Georgia-Tech-GNC/telemetry-board-pcb/README.md

# KiCad Project Template
Copy this template to quickly start a new KiCad project.

## Setup Steps
1. Copy template
2. SOME STUFF
3. Add libraries to project library table
