Georgia-Tech-GNC/telemetry-board-pcb/telemetry.step

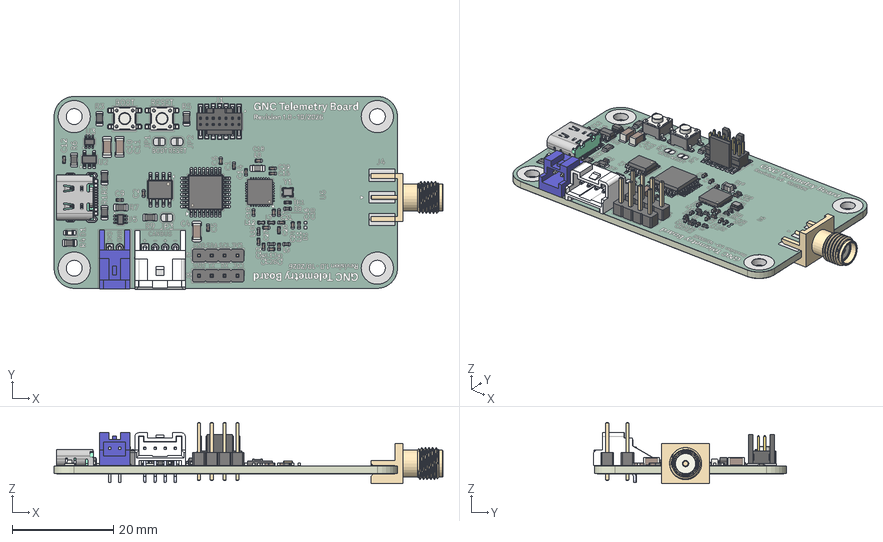
[picture p1: CAD file, 2026-11-03]
telemetry.step
77.0 x 38.3 x 12.1 mm
L_0402_1005Metric x 6
L_0805_2012Metric
QFN-32-1EP_5x5mm_P0.5mm_EP3.7x3.7mm
C_0402_1005Metric x 21
PinHeader_1x04_P254mm_Vertical x 2
SOT-363_SC-70-6 x 2
LQFP-32_7x7mm_P0.8mm
R_0402_1005Metric x 2
C_1206_3216Metric x 3
Crystal_SMD_2016-4Pin_2.0x1.6mm
R_0805_2012Metric x 8
S02B-PASK-2
SOIC-8_3.9x4.9mm_P1.27mm
_X2_4E006B21_X0_MOLDING_-261340
SW_SPST_PTS647Sx38 x 2
SMA_Molex_73251-1153_EdgeMount_Horizontal
LED_0603_1608Metric
FTSH-107-01-L-DV-K-A_body
FTSH-107-01-L-DV-K-A_pins1
FTSH-107-01-L-DV-K-A_pins2
SOT-23-5
telemetry-unsaved-export-rzqZC5_copper
telemetry-unsaved-export-rzqZC5_pad
telemetry-unsaved-export-rzqZC5_silkscreen x 2
telemetry-unsaved-export-rzqZC5_soldermask x 2
telemetry-unsaved-export-rzqZC5_PCB
