Georgia-Tech-GNC/telemetry-board-pcb/telemetry.kicad_pcb

## KiCad design telemetry.kicad_pcb (2026-11-03)

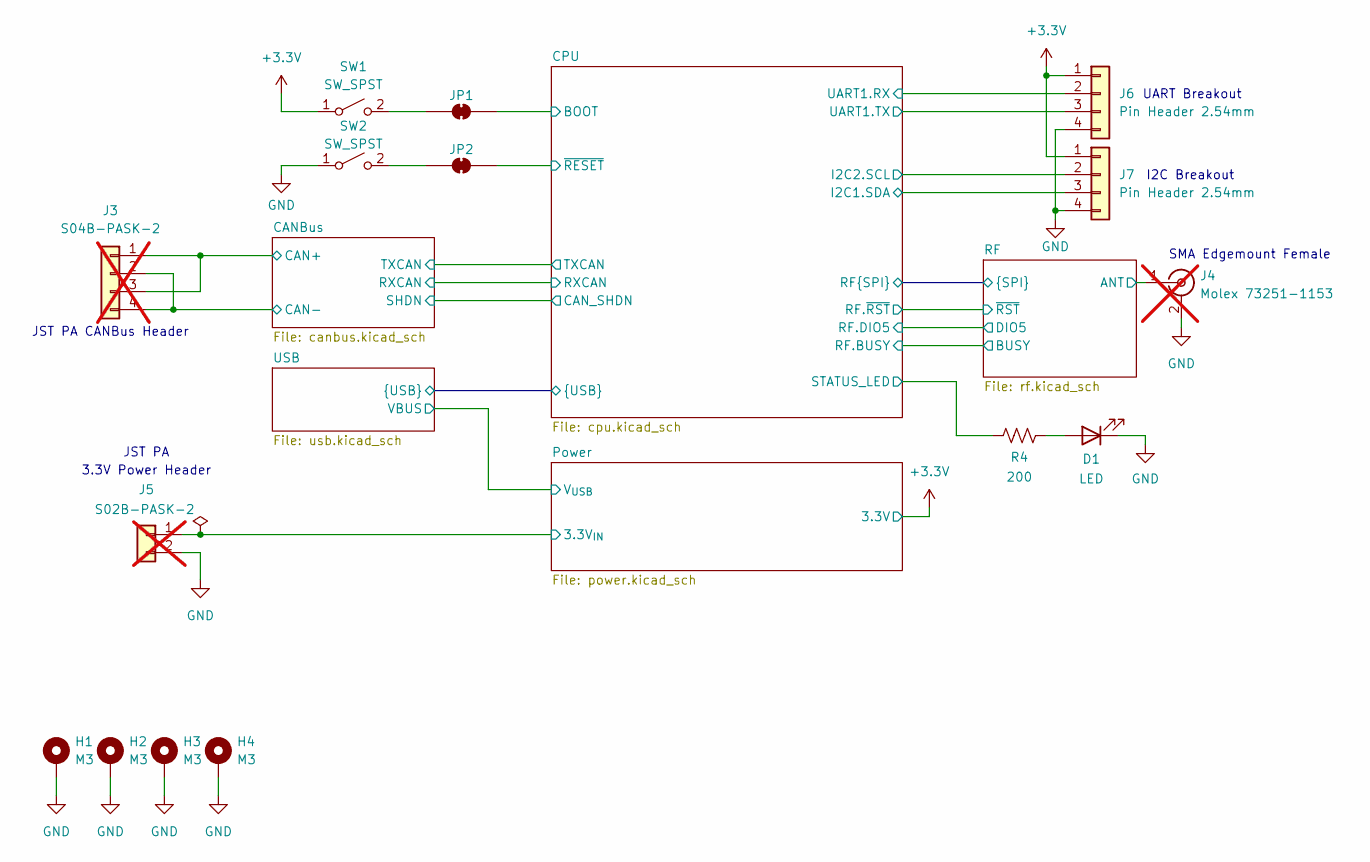
[picture p2: schematic telemetry.kicad_sch, Telemetry Board]

Parts:
D1: LED; LED_0603_1608Metric; MPN KT-0603R; LCSC C2286
H1, H2, H3, H4: M3; MountingHole_3.2mm_M3_Pad
J3: S04B-PASK-2; JST_S04B-PASK-2_LF__SN_; MPN S04B-PASK-2; Digikey 455-S04B-PASK-2-ND; not fitted
J4: Molex 73251-1153; SMA_Molex_73251-1153_EdgeMount_Horizontal; MPN 732511150; LCSC C841205; not fitted
J5: S02B-PASK-2; JST_S02B-PASK-2; MPN S02B-PASK-2; Digikey 455-S02B-PASK-2-ND; not fitted
J6, J7: Pin Header 2.54mm; PinHeader_1x04_P2.54mm_Vertical
JP1, JP2: SolderJumper_2_Bridged; SolderJumper-2_P1.3mm_Bridged_RoundedPad1.0x1.5mm
R4: 200; R_0805_2012Metric; MPN 0805W8F2000T5E; LCSC C17540
SW1, SW2: SW_SPST; SW_SPST_PTS647_Sx38; MPN PTS 647 SN38 SMTR2 LFS; LCSC C2799279

Connections:
+3.3V: J6.1, J7.1, SW1.1 (A); also elsewhere on the board
/CANBus/CAN+: J3.1, J3.3; also elsewhere on the board
/CANBus/CAN-: J3.2, J3.4; also elsewhere on the board
/CPU/BOOT: JP1.2 (B); also elsewhere on the board
/CPU/I2C1.SDA: J7.3; also elsewhere on the board
/CPU/I2C2.SCL: J7.2; also elsewhere on the board
/CPU/STATUS_LED: R4.1; also elsewhere on the board
/CPU/UART1.RX: J6.2; also elsewhere on the board
/CPU/UART1.TX: J6.3; also elsewhere on the board
/CPU/~RESET: JP2.2 (B); also elsewhere on the board
/Power/3.3V_{IN}: J5.1; also elsewhere on the board
/RF/ANT: J4.1 (In); also elsewhere on the board
GND: D1.1 (K), H1.1 (1_1), H2.1 (1_1), H3.1 (1_1), H4.1 (1_1), J4.2 (Ext), J5.2, J6.4, J7.4, SW2.1 (A); also elsewhere on the board
unnamed: D1.2 (A), R4.2
unnamed: JP1.1 (A), SW1.2 (B)
unnamed: JP2.1 (A), SW2.2 (B)

Notes on the sheet:
I2C Breakout
JST PA CANBus Header
3.3V Power Header
UART Breakout
SMA Edgemount Female
JST PA

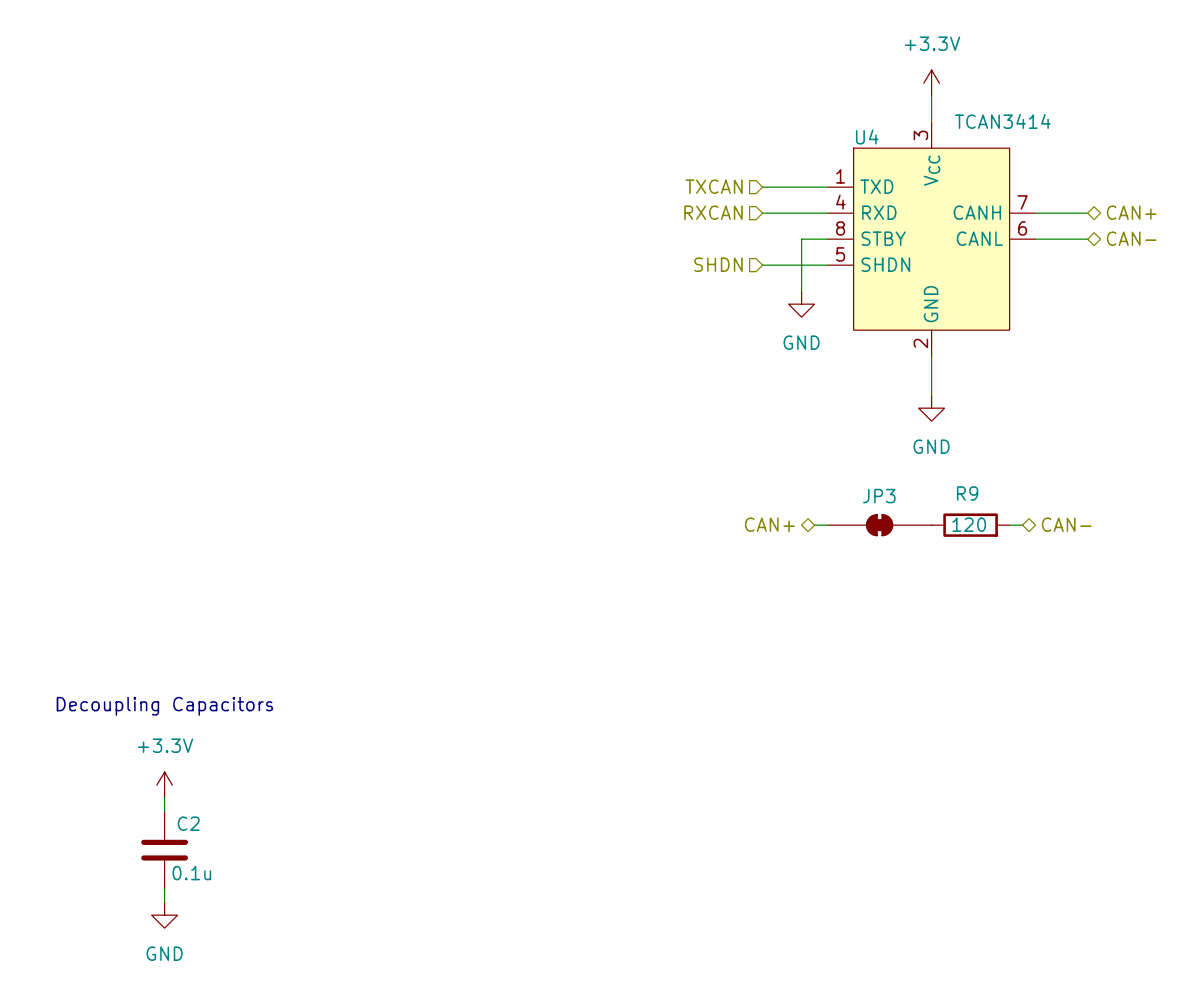
[picture p3: schematic canbus.kicad_sch]

Parts:
C2: 0.1u; C_0402_1005Metric; MPN CL05B104KO5NNNC; Digikey 1276-1003-1-ND
JP3: SolderJumper_2_Bridged; SolderJumper-2_P1.3mm_Bridged_RoundedPad1.0x1.5mm
R9: 120; R_0805_2012Metric; MPN 0805W8F1200T5E; LCSC C17437
U4: TCAN3414; SOIC-8_3.9x4.9mm_P1.27mm; MPN TCAN3413DR; LCSC C22433320

Connections:
+3.3V: C2.1, U4.3 (V_{CC}); also elsewhere on the board
/CANBus/CAN+: JP3.1 (A), U4.7 (CANH); also elsewhere on the board
/CANBus/CAN-: R9.2, U4.6 (CANL); also elsewhere on the board
/CANBus/RXCAN: U4.4 (RXD); also elsewhere on the board
/CANBus/SHDN: U4.5 (SHDN); also elsewhere on the board
/CANBus/TXCAN: U4.1 (TXD); also elsewhere on the board
GND: C2.2, U4.2 (GND), U4.8 (STBY); also elsewhere on the board
unnamed: JP3.2 (B), R9.1

Notes on the sheet:
Decoupling Capacitors

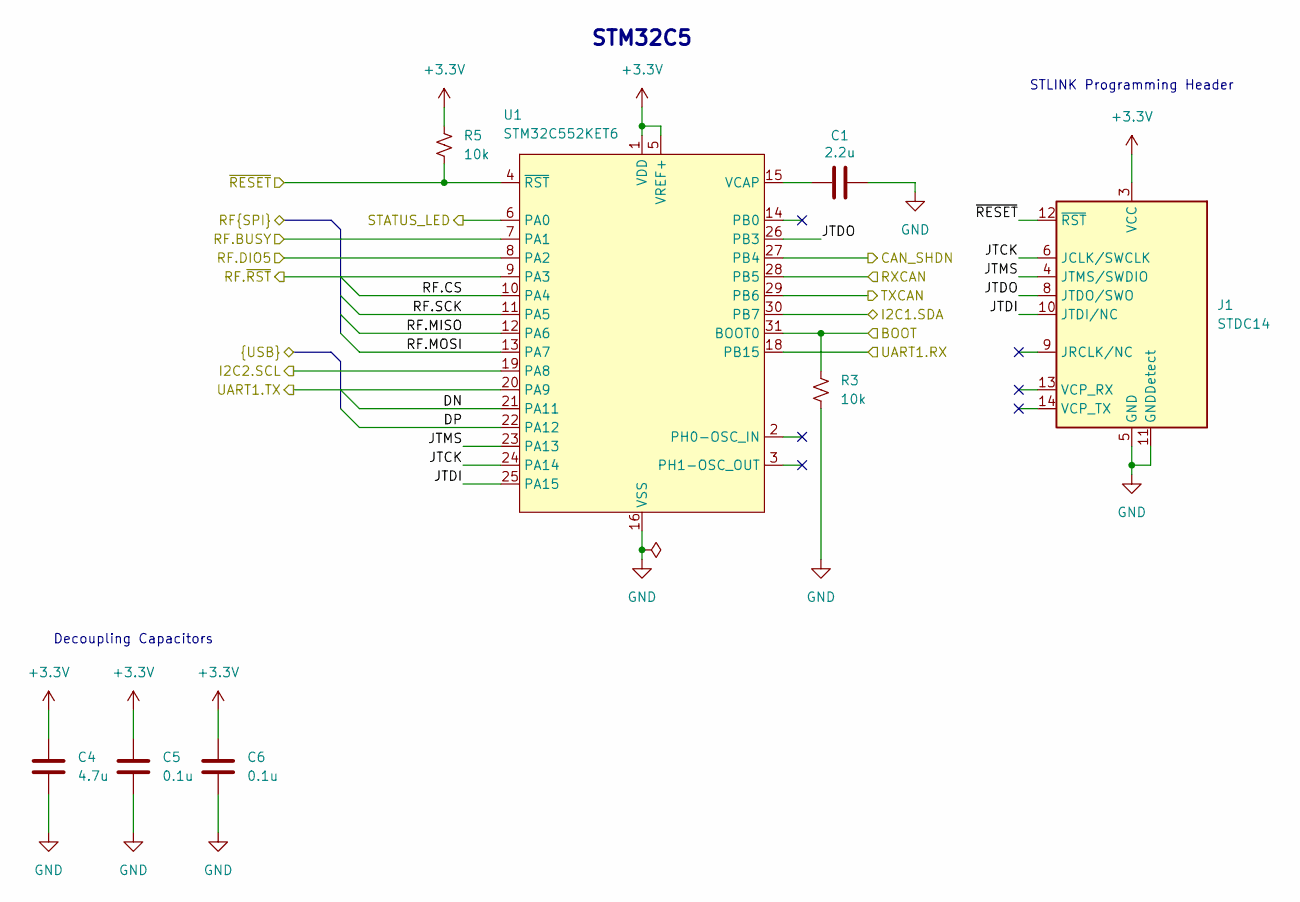
[picture p4: schematic cpu.kicad_sch, STM32C5]

Parts:
C1: 2.2u; C_0402_1005Metric; MPN CL05A225MQ5NSNC; LCSC C12530
C4: 4.7u; C_1206_3216Metric; MPN CL31B475KBHNNNE; LCSC C51205
C5, C6: 0.1u; C_0402_1005Metric; MPN CL05B104KO5NNNC; Digikey 1276-1003-1-ND
J1: STDC14; SAMTEC_FTSH-107-01-L-DV-K-A; MPN FTSH-107-01-L-DV-K-A; LCSC C5563894
R3, R5: 10k; R_0805_2012Metric; MPN 0805W8F1002T5E; LCSC C17414
U1: STM32C552KET6; LQFP-32_7x7mm_P0.8mm; MPN STM32C552KET6; Digikey 497-STM32C552KET6-ND

Connections:
+3.3V: C4.1, C5.1, C6.1, J1.3 (VCC), R5.1, U1.1 (VDD), U1.5 (VREF+), U1.17 (VDD); also elsewhere on the board
/CANBus/RXCAN: U1.28 (PB5); also elsewhere on the board
/CANBus/SHDN: U1.27 (PB4); also elsewhere on the board
/CANBus/TXCAN: U1.29 (PB6); also elsewhere on the board
/CPU/BOOT: R3.1, U1.31 (BOOT0); also elsewhere on the board
/CPU/DN: U1.21 (PA11); also elsewhere on the board
/CPU/DP: U1.22 (PA12); also elsewhere on the board
/CPU/I2C1.SDA: U1.30 (PB7); also elsewhere on the board
/CPU/I2C2.SCL: U1.19 (PA8); also elsewhere on the board
/CPU/JTCK: J1.6 (JCLK/SWCLK), U1.24 (PA14)
/CPU/JTDI: J1.10 (JTDI/NC), U1.25 (PA15)
/CPU/JTDO: J1.8 (JTDO/SWO), U1.26 (PB3)
/CPU/JTMS: J1.4 (JTMS/SWDIO), U1.23 (PA13)
/CPU/RF.BUSY: U1.7 (PA1); also elsewhere on the board
/CPU/RF.CS: U1.10 (PA4); also elsewhere on the board
/CPU/RF.DIO5: U1.8 (PA2); also elsewhere on the board
/CPU/RF.MISO: U1.12 (PA6); also elsewhere on the board
/CPU/RF.MOSI: U1.13 (PA7); also elsewhere on the board
/CPU/RF.SCK: U1.11 (PA5); also elsewhere on the board
/CPU/RF.~RST: U1.9 (PA3); also elsewhere on the board
/CPU/STATUS_LED: U1.6 (PA0); also elsewhere on the board
/CPU/UART1.RX: U1.18 (PB15); also elsewhere on the board
/CPU/UART1.TX: U1.20 (PA9); also elsewhere on the board
/CPU/~RESET: J1.12 (~RST), R5.2, U1.4 (~RST); also elsewhere on the board
GND: C1.2, C4.2, C5.2, C6.2, J1.5 (GND), J1.7 (GND), J1.11 (GNDDetect), R3.2, U1.16 (VSS), U1.32 (VSS); also elsewhere on the board
unnamed: C1.1, U1.15 (VCAP)

Notes on the sheet:
STLINK Programming Header
Decoupling Capacitors
STM32C5

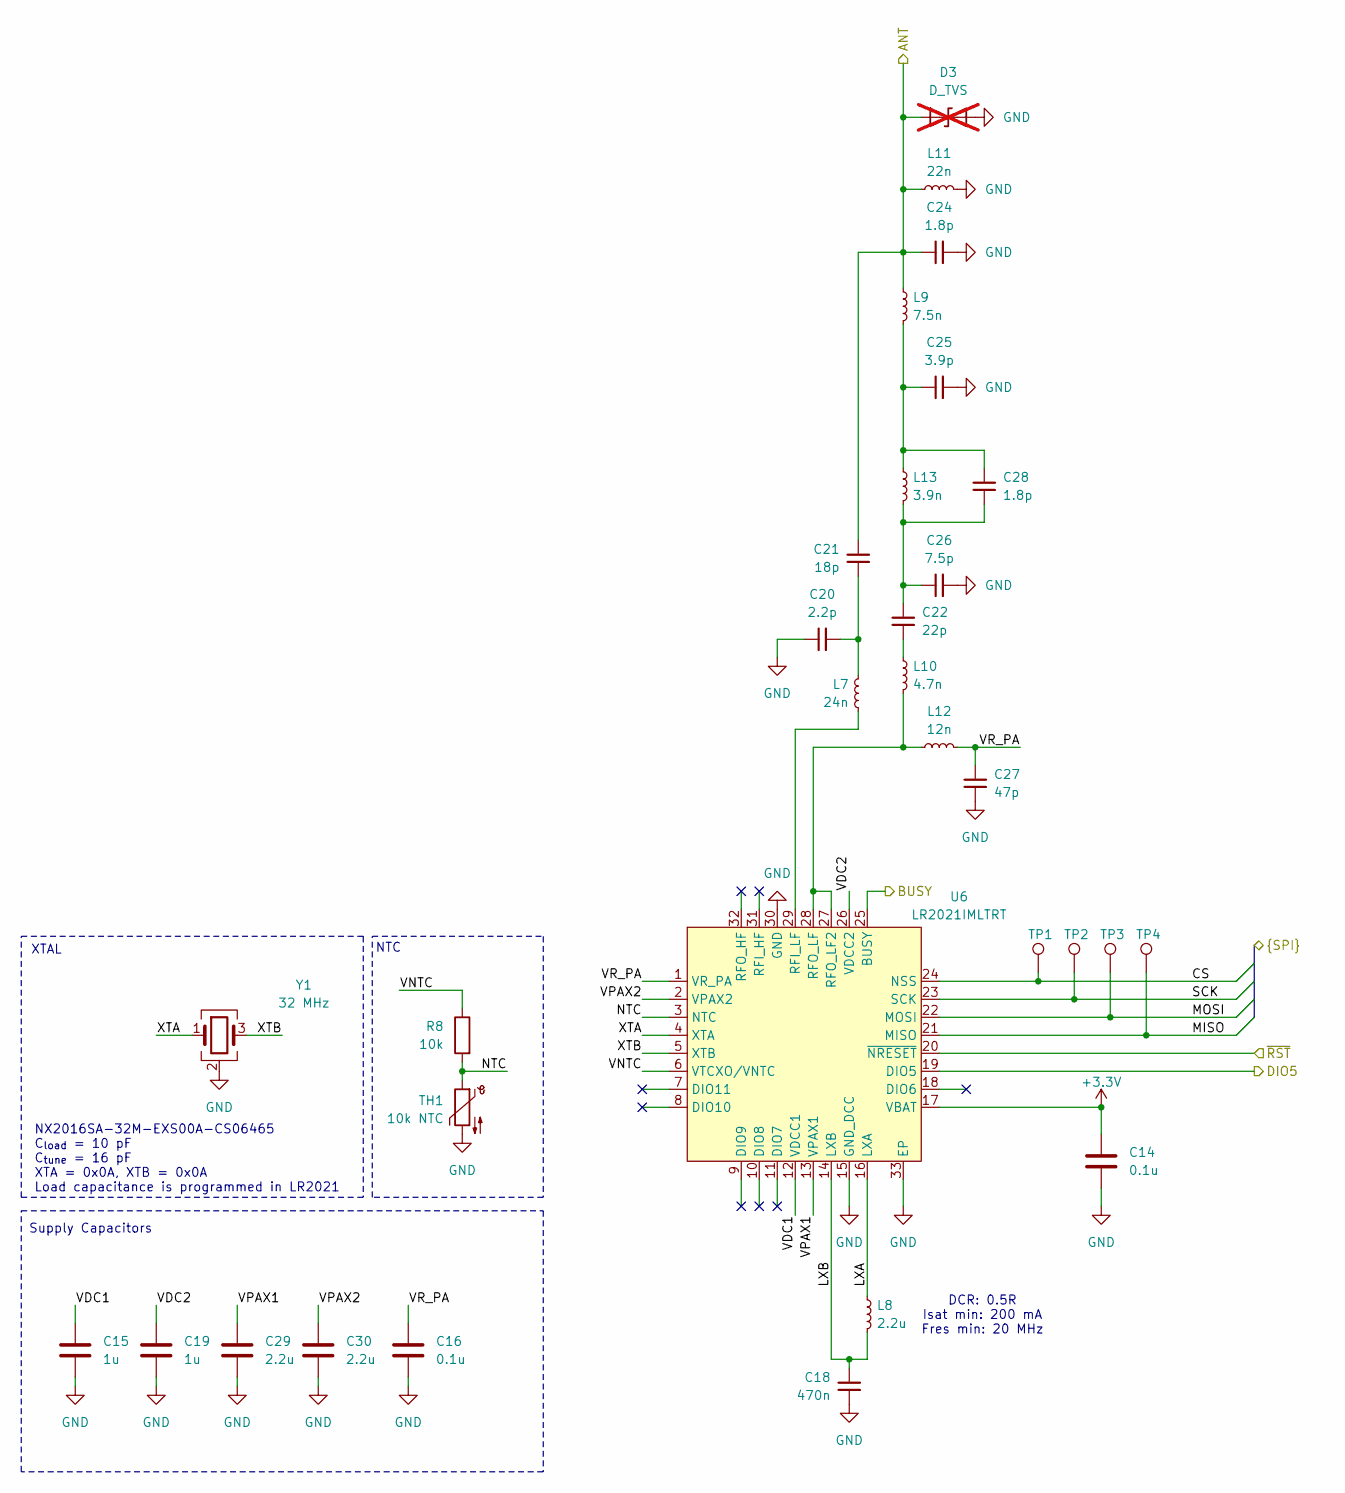
[picture p5: schematic rf.kicad_sch]

Parts:
C14: 0.1u; C_0402_1005Metric; MPN CL05B104KO5NNNC; Digikey 1276-1003-1-ND
C15, C19: 1u; C_0402_1005Metric; MPN CL05A105KO5NNNC; LCSC C29266
C16: 0.1u; C_0402_1005Metric; MPN CL05B104KO5NNNC; LCSC C1525
C18: 470n; C_0402_1005Metric; MPN CL05A474KP5NNNC; LCSC C47339
C20: 2.2p; C_0402_1005Metric; MPN 0402CG2R2C500NT; LCSC C1559
C21: 18p; C_0402_1005Metric; MPN 0402CG180J500NT; LCSC C1549
C22: 22p; C_0402_1005Metric; MPN 0402CG220J500NT; LCSC C1555
C24, C28: 1.8p; C_0402_1005Metric; MPN 0402CG1R8C500NT; LCSC C1553
C25: 3.9p; C_0402_1005Metric; MPN 0402CG3R9C500NT; LCSC C1566
C26: 7.5p; C_0402_1005Metric; MPN 0402CG7R5C500NT; LCSC C43514
C27: 47p; C_0402_1005Metric; MPN 0402CG470J500NT; LCSC C1567
C29, C30: 2.2u; C_0402_1005Metric; MPN CL05A225MQ5NSNC; LCSC C12530
D3: D_TVS; D_0402_1005Metric; not fitted
L7: 24n; L_0402_1005Metric; MPN LQW15AN24NG80D; LCSC C668462
L8: 2.2u; L_0805_2012Metric; MPN CMI201209U2R2KT; LCSC C1043
L9: 7.5n; L_0402_1005Metric; MPN LQW15AN7N5G00D; LCSC C82918
L10: 4.7n; L_0402_1005Metric; MPN LQG15HS4N7B02D; LCSC C162543
L11: 22n; L_0402_1005Metric; MPN LQW15AN22NG00D; LCSC C86129
L12: 12n; L_0402_1005Metric; MPN LQW15AN12NG80D; LCSC C3223181
L13: 3.9n; L_0402_1005Metric; MPN SDCL1005C3N9STDF; LCSC C14033
R8: 10k; R_0402_1005Metric; MPN 0402WGF1002TCE; LCSC C25744
TH1: 10k NTC; R_0402_1005Metric; MPN NTCG103JF103FT1S; LCSC C5121989
TP1, TP2, TP3, TP4: TestPoint; TestPoint_Pad_D1.5mm
U6: LR2021IMLTRT; QFN-32-1EP_5x5mm_P0.5mm_EP3.7x3.7mm; MPN LR2021IMLTRT; LCSC C49421489
Y1: 32 MHz; Crystal_SMD_2016-4Pin_2.0x1.6mm; MPN NX2016SA-32M-EXS00A-CS06465; LCSC C1986260

Connections:
+3.3V: C14.1, U6.17 (VBAT); also elsewhere on the board
/CPU/RF.BUSY: U6.25 (BUSY); also elsewhere on the board
/CPU/RF.CS: TP1.1 (1_1), U6.24 (NSS); also elsewhere on the board
/CPU/RF.DIO5: U6.19 (DIO5); also elsewhere on the board
/CPU/RF.MISO: TP4.1 (1_1), U6.21 (MISO); also elsewhere on the board
/CPU/RF.MOSI: TP3.1 (1_1), U6.22 (MOSI); also elsewhere on the board
/CPU/RF.SCK: TP2.1 (1_1), U6.23 (SCK); also elsewhere on the board
/CPU/RF.~RST: U6.20 (~NRESET); also elsewhere on the board
/RF/ANT: C21.2, C24.1, D3.1 (A1), L9.1, L11.1; also elsewhere on the board
/RF/LXA: L8.1, U6.16 (LXA)
/RF/LXB: C18.1, L8.2, U6.14 (LXB)
/RF/NTC: R8.2, TH1.1, U6.3 (NTC)
/RF/VDC1: C15.1, U6.12 (VDCC1)
/RF/VDC2: C19.1, U6.26 (VDCC2)
/RF/VNTC: R8.1, U6.6 (VTCXO/VNTC)
/RF/VPAX1: C29.1, U6.13 (VPAX1)
/RF/VPAX2: C30.1, U6.2 (VPAX2)
/RF/VR_PA: C16.1, C27.1, L12.2, U6.1 (VR_PA)
/RF/XTA: U6.4 (XTA), Y1.1
/RF/XTB: U6.5 (XTB), Y1.3
GND: C14.2, C15.2, C16.2, C18.2, C19.2, C20.1, C24.2, C25.2, C26.2, C27.2, C29.2, C30.2, D3.2 (A2), L11.2, TH1.2, U6.15 (GND_DCC), U6.30 (GND), U6.33 (EP), Y1.2 (G), Y1.4 (G); also elsewhere on the board
unnamed: C20.2, C21.1, L7.1
unnamed: C22.1, L10.1
unnamed: C22.2, C26.1, C28.1, L13.2
unnamed: C25.1, C28.2, L9.2, L13.1
unnamed: L7.2, U6.29 (RFI_LF)
unnamed: L10.2, L12.1, U6.27 (RFO_LF2), U6.28 (RFO_LF)

Notes on the sheet:
Supply Capacitors
XTAL
DCR: 0.5R Isat min: 200 mA Fres min: 20 MHz
NX2016SA-32M-EXS00A-CS06465 C_{load} = 10 pF C_{tune} = 16 pF XTA = 0x0A, XTB = 0x0A Load capacitance is programmed in LR2021
NTC

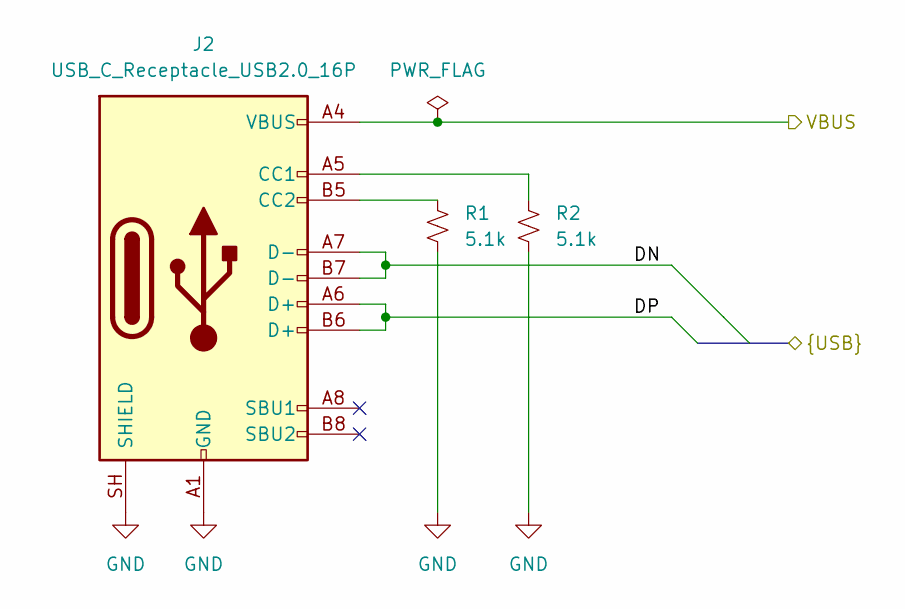
[picture p6: schematic usb.kicad_sch, USB-C]

Parts:
J2: USB_C_Receptacle_USB2.0_16P; AMPHENOL_12402012E212A; MPN GT-USB-9010A; Digikey 664-12402012E212ACT-ND
R1, R2: 5.1k; R_0805_2012Metric; MPN 0805W8F5101T5E; LCSC C27834

Connections:
/CPU/DN: J2.A7 (D-), J2.B7 (D-); also elsewhere on the board
/CPU/DP: J2.A6 (D+), J2.B6 (D+); also elsewhere on the board
/Power/V_{USB}: J2.A4 (VBUS), J2.A9 (VBUS), J2.B4 (VBUS), J2.B9 (VBUS); also elsewhere on the board
GND: J2.A1 (GND), J2.A12 (GND), J2.B1 (GND), J2.B12 (GND), J2.SH (SHIELD), R1.2, R2.2; also elsewhere on the board
unnamed: J2.A5 (CC1), R2.1
unnamed: J2.B5 (CC2), R1.1

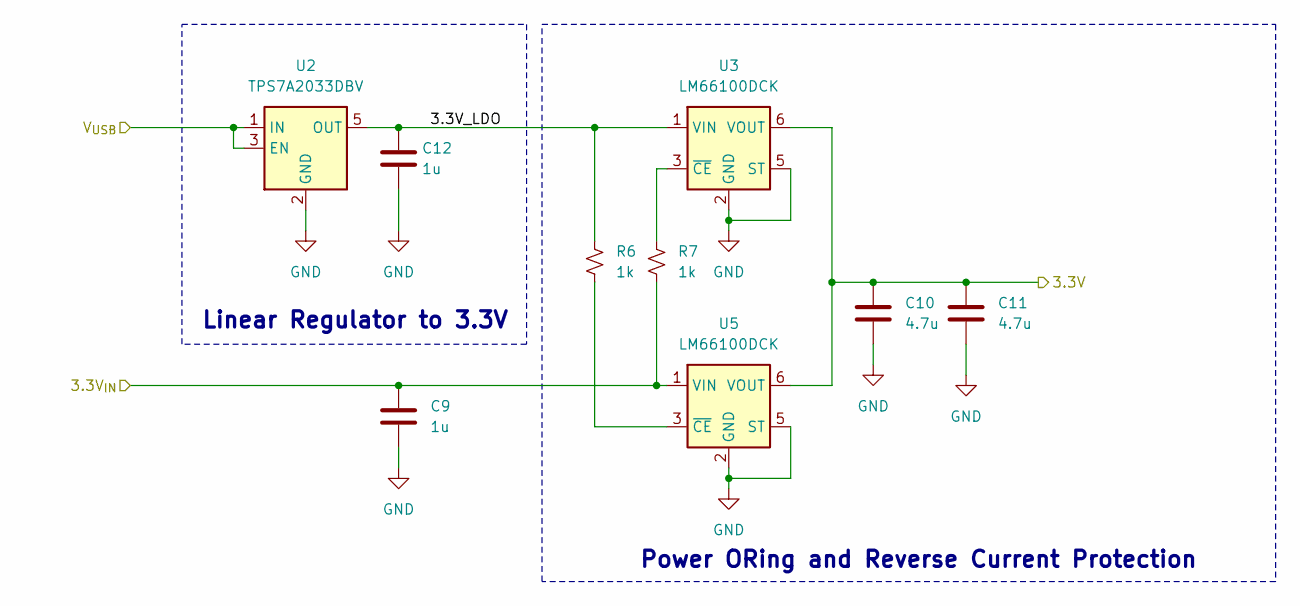
[picture p7: schematic power.kicad_sch, Power Regulation]

Parts:
C9, C12: 1u; C_0402_1005Metric; MPN CL05A105KO5NNNC; LCSC C29266
C10, C11: 4.7u; C_1206_3216Metric; MPN CL31B475KBHNNNE; LCSC C51205
R6, R7: 1k; R_0805_2012Metric; MPN 0805W8F1001T5E; LCSC C17513
U2: TPS7A2033DBV; SOT-23-5; MPN TPS7A2033PDBVR; LCSC C2862740
U3, U5: LM66100DCK; SOT-363_SC-70-6; MPN LM66100DCKR; LCSC C2869734

Connections:
+3.3V: C10.1, C11.1, U3.6 (VOUT), U5.6 (VOUT); also elsewhere on the board
/Power/3.3V_LDO: C12.1, R6.1, U2.5 (OUT), U3.1 (VIN)
/Power/3.3V_{IN}: C9.1, R7.2, U5.1 (VIN); also elsewhere on the board
/Power/V_{USB}: U2.1 (IN), U2.3 (EN); also elsewhere on the board
GND: C9.2, C10.2, C11.2, C12.2, U2.2 (GND), U3.2 (GND), U3.5 (ST), U5.2 (GND), U5.5 (ST); also elsewhere on the board
unnamed: R7.1, U3.3 (~CE)
unnamed: R6.2, U5.3 (~CE)

Notes on the sheet:
Linear Regulator to 3.3V
Power ORing and Reverse Current Protection

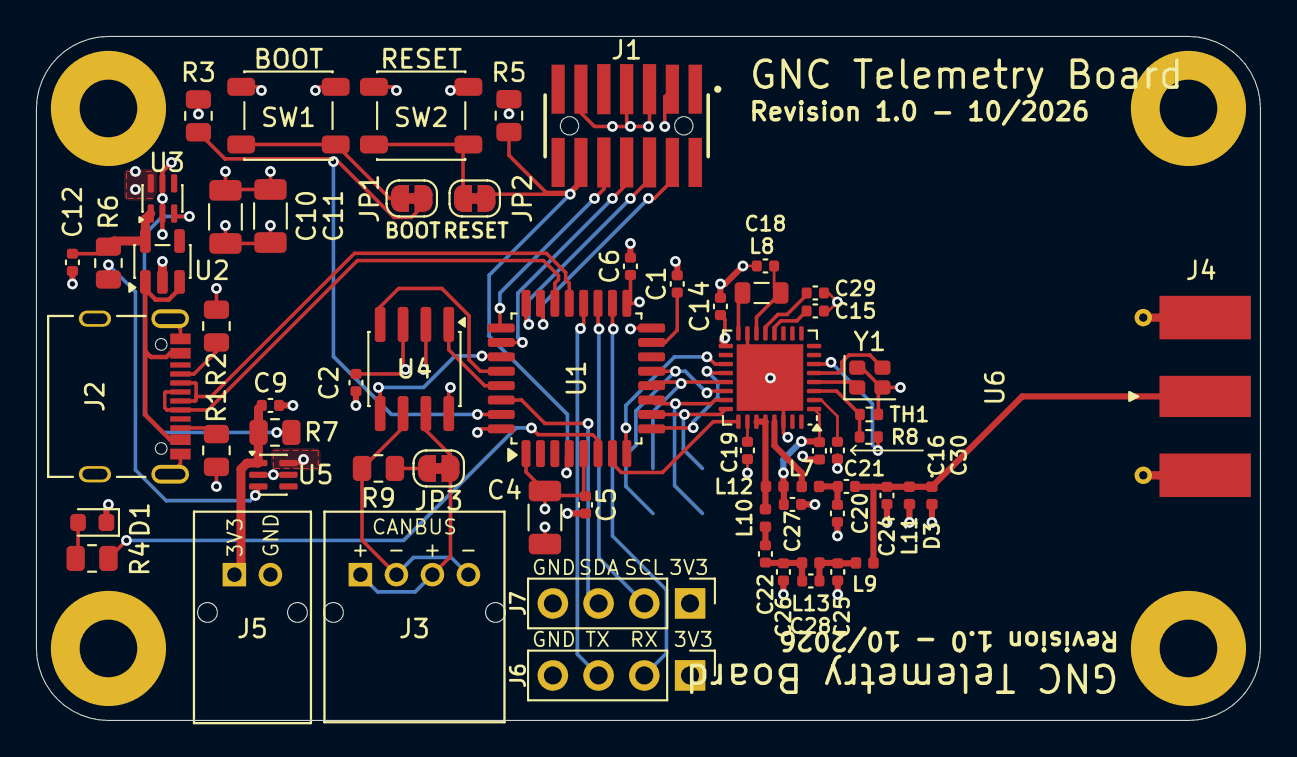
[picture p8: board telemetry.kicad_pcb from above]

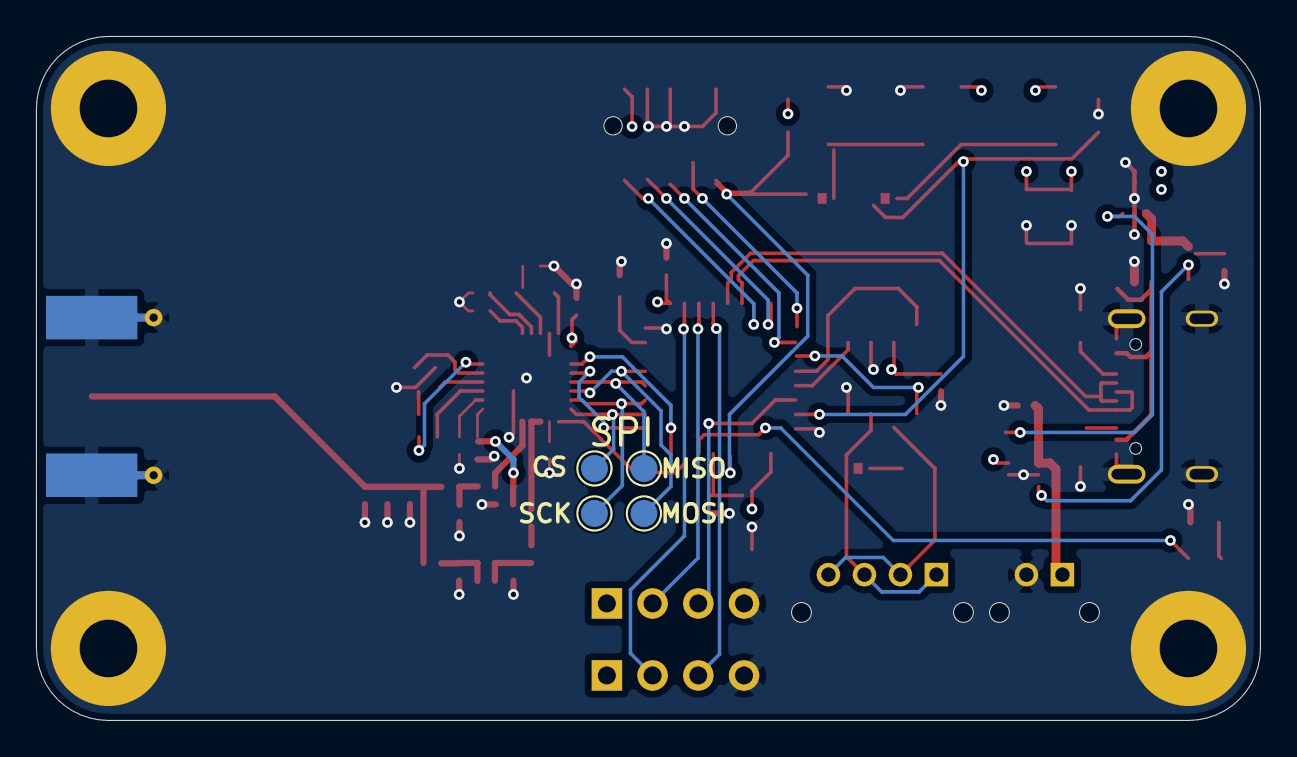
[picture p9: board telemetry.kicad_pcb from below]

Board: 4 copper layers, 68.0 x 38.0 mm, 70 parts (4 on the bottom side), 57 nets.
